Pedro-Molina/Cap_Ind/(list of files, drawings)

Other design files:
New Project.pdsprj
PCB/PCB.pdsprj
