Pedro-Molina/Cap_Ind/(commit log)

2021-11-15 anda RC y RLC
    [New Project.pdsprj]
2021-11-15 una linea random
    [New Project.pdsprj]
2021-11-15 volvio a andar el RLC
    [New Project.pdsprj]
2021-11-15 cambio en timer
    [New Project.pdsprj]
2021-11-15 modularizacion en rc y lcd
    [New Project.pdsprj]
2021-11-16 PDF ya para entregar y proyecto PCB agregado
    [PCB.pdsprj]
